comradef191/OpenShockMini/Mini/Gallery/r1.1_back.png

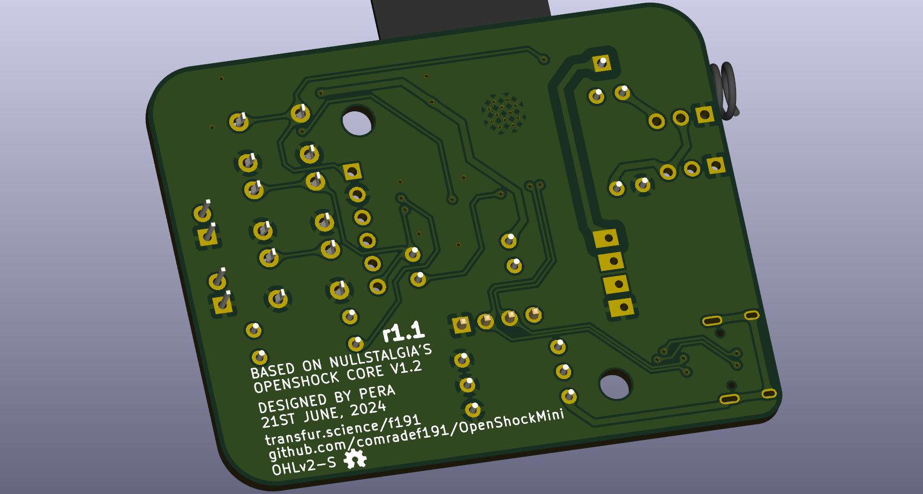
Mini/Gallery/r1.1_back.png
