comradef191/OpenShockMini/Mini/Gallery/r1.1_front-empty.png

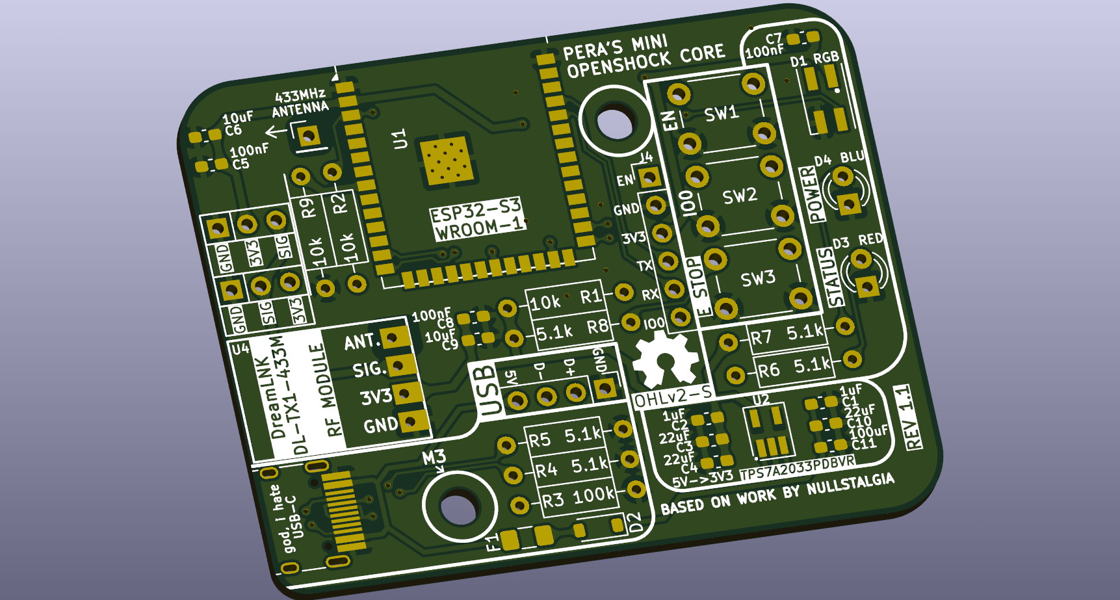
Mini/Gallery/r1.1_front-empty.png
