comradef191/OpenShockMini/Mini/Gallery/r1.1_front.png

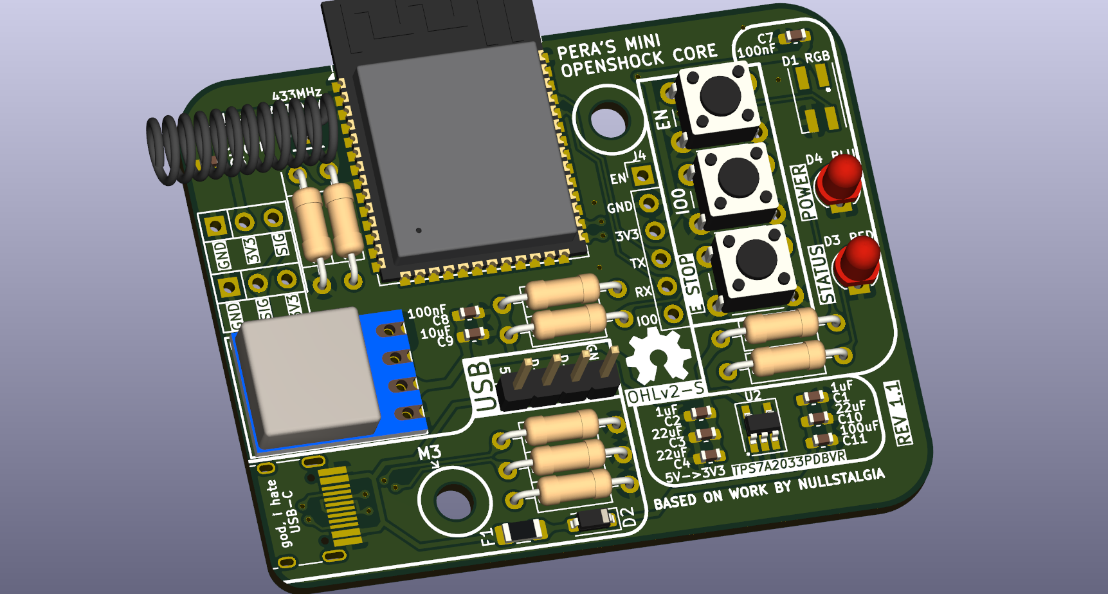
Mini/Gallery/r1.1_front.png
