comradef191/OpenShockMini/Mini/Schematic.pdf

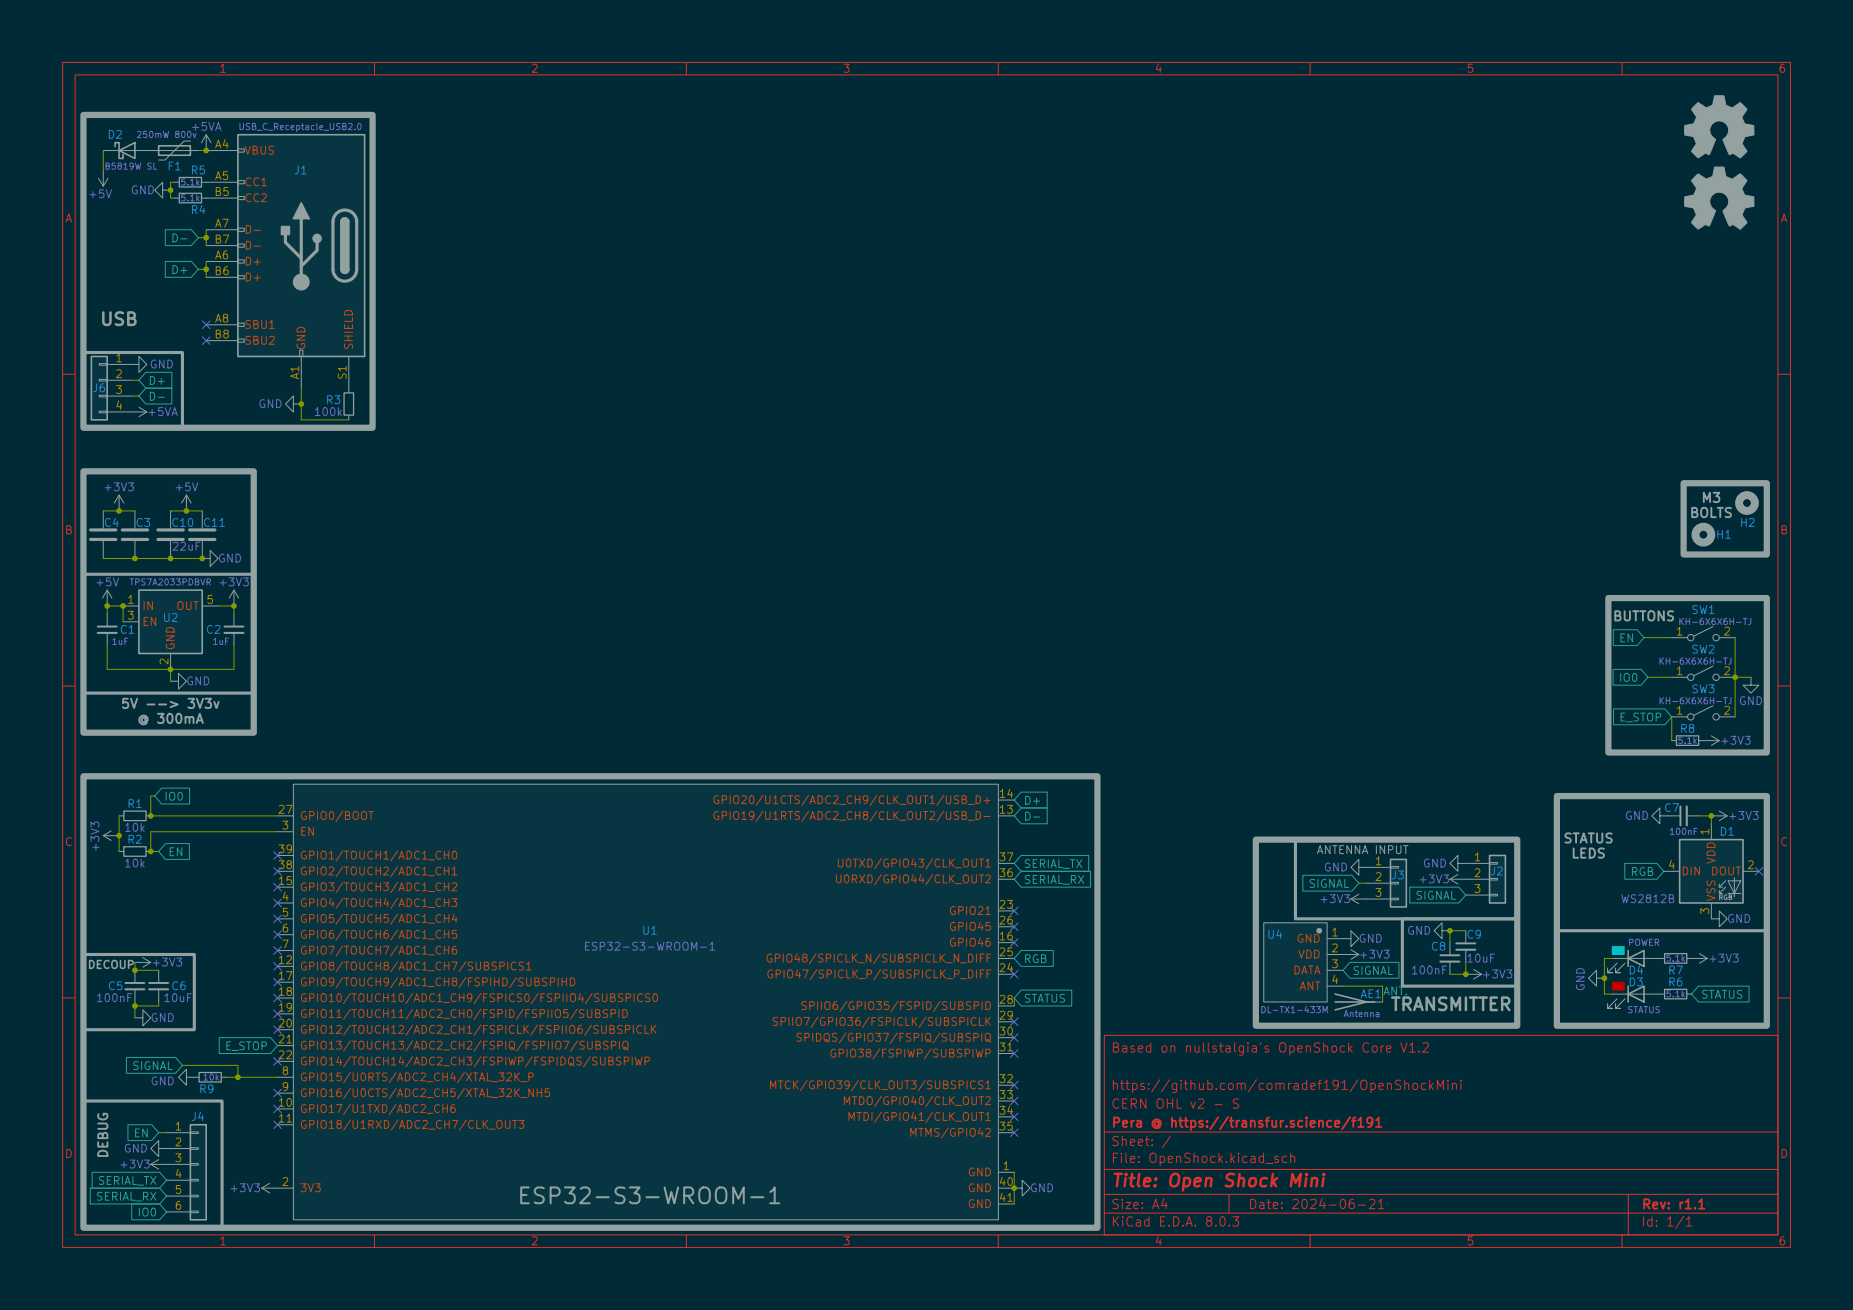
[picture p7: page 1]
