comradef191/OpenShockMini/Mini/OpenShock.kicad_pcb

## KiCad design Mini/OpenShock.kicad_pcb (2024-09-15)

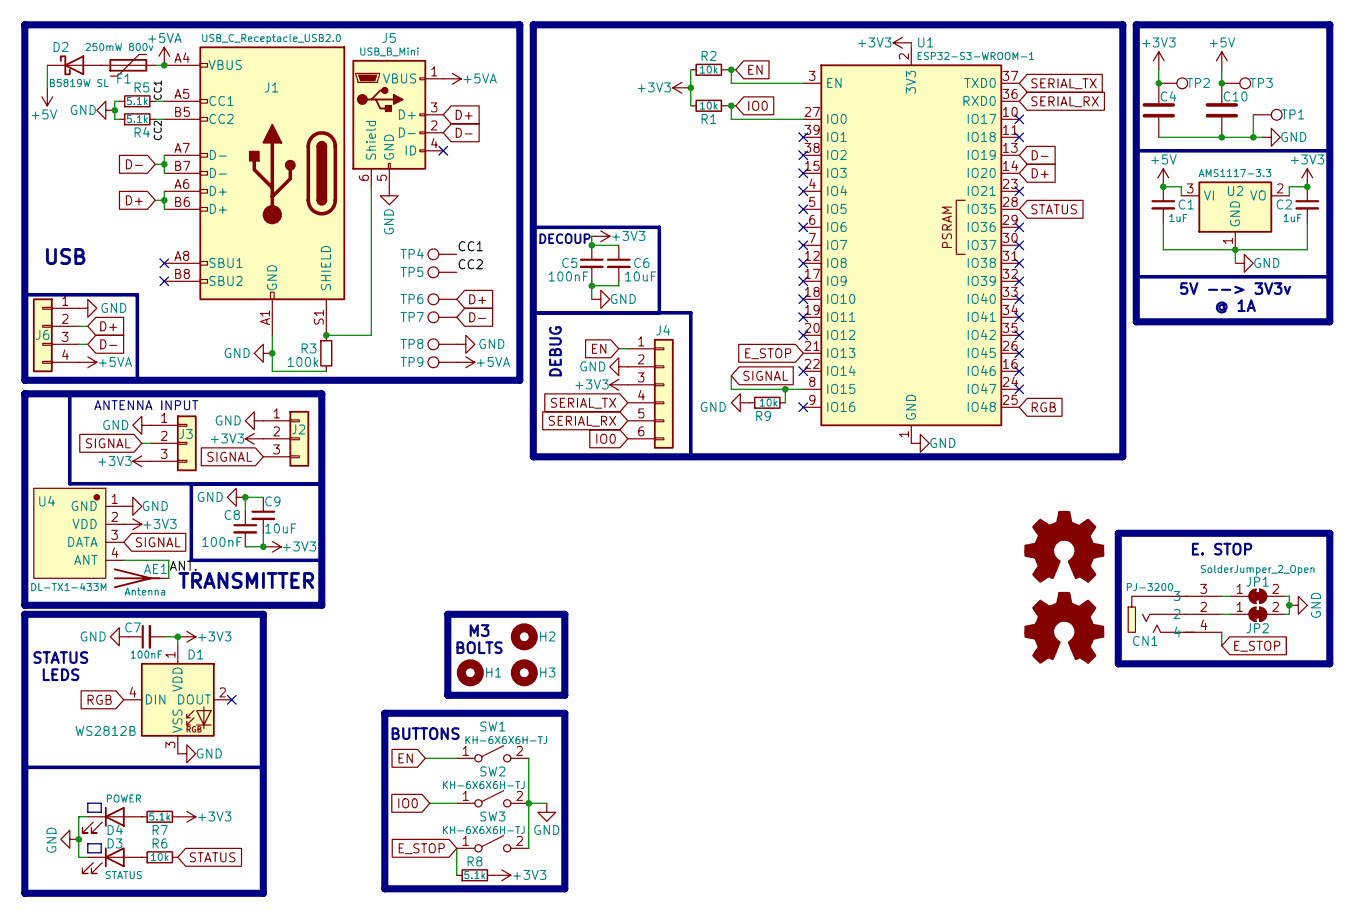
[picture p8: schematic OpenShock.kicad_sch, Open Shock Mini]

Parts:
AE1: Antenna; PinHeader_1x01_P2.54mm_Vertical
C1, C2: 1uF; C_0805_2012Metric_Pad1.18x1.45mm_HandSolder; LCSC C215803
C4, C10: 22uF; C_0805_2012Metric_Pad1.18x1.45mm_HandSolder; LCSC C98190
C5, C7, C8: 100nF; C_0805_2012Metric_Pad1.18x1.45mm_HandSolder; LCSC C476766
C6, C9: 10uF; C_0805_2012Metric_Pad1.18x1.45mm_HandSolder; LCSC C1713
CN1: PJ-3200; AUDIO-TH_PJ-3200; LCSC C2689690
D1: WS2812B; LED_WS2812B-Mini_3.5x3.5mm_P1.75mm; LCSC C527089
D2: B5819W SL; D_SOD-123; LCSC C8598
D3: STATUS; LED_D3.0mm; LCSC C440523
D4: POWER; LED_D3.0mm; LCSC C2895474
F1: 250mW 800v; Fuse_1206_3216Metric_Pad1.42x1.75mm_HandSolder; LCSC C17888
H1, H2, H3: MountingHole; MountingHole_3.2mm_M3_ISO7380
J1: USB_C_Receptacle_USB2.0; HRO-TYPE-C-31-M-12-HandSoldering_ABPads; LCSC C165948
J2, J3: Conn_01x03; PinHeader_1x03_P2.54mm_Vertical
J4: Conn_01x06; PinHeader_1x06_P2.54mm_Vertical
J5: USB_B_Mini; MICRO-USB-TH_UX-150-ARG4; LCSC C720612
J6: Conn_01x04; PinHeader_1x04_P2.54mm_Vertical
JP1, JP2: SolderJumper_2_Open; SolderJumper-2_P1.3mm_Bridged_RoundedPad1.0x1.5mm
R1, R2, R6, R9: 10k; THT-Resistor_Customised
R3: 100k; THT-Resistor_Customised
R4, R5, R7, R8: 5.1k; THT-Resistor_Customised
SW1, SW2, SW3: KH-6X6X6H-TJ; SW_PUSH_6mm; LCSC C2837516
TP1, TP2, TP3, TP4, TP5, TP6, TP7, TP8, TP9: TestPoint; TestPoint_Pad_D1.5mm
U1: ESP32-S3-WROOM-1; LCSC C2913202
U2: AMS1117-3.3; SOT-89-3_Handsoldering; LCSC C5120796
U4: DL-TX1-433M; WIELM-TH_DL-TX1-433M; LCSC C381160

Connections:
+3V3: C2.1, C4.1, C5.1, C6.1, C7.2, C8.2, C9.2, D1.1 (VDD), J2.2, J3.3, J4.3, R1.2, R2.1, R7.2, R8.2, TP2.1, U1.2 (3V3), U2.2 (VO), U4.2 (VDD)
+5V: C1.1, C10.1, D2.1 (K), TP3.1, U2.3 (VI)
+5VA: F1.2, J1.A4 (VBUS), J1.A9 (VBUS), J1.B4 (VBUS), J1.B9 (VBUS), J5.1 (VBUS), J6.4, TP9.1
/ANT.: AE1.1 (A), U4.4 (ANT)
/CC1: J1.A5 (CC1), R5.2, TP4.1
/CC2: J1.B5 (CC2), R4.2, TP5.1
D+: J1.A6 (D+), J1.B6 (D+), J5.3 (D+), J6.2, TP6.1, U1.14 (IO20)
D-: J1.A7 (D-), J1.B7 (D-), J5.2 (D-), J6.3, TP7.1, U1.13 (IO19)
EN: J4.1, R2.2, SW1.1 (A), U1.3 (EN)
E_STOP: CN1.4, R8.1, SW3.1 (A), U1.21 (IO13)
GND: C1.2, C2.2, C4.2, C5.2, C6.2, C7.1, C8.1, C9.1, C10.2, D1.3 (VSS), D3.1 (K), D4.1 (K), J1.A1 (GND), J1.A12 (GND), J1.B1 (GND), J1.B12 (GND), J2.1, J3.1, J4.2, J5.5 (GND), J6.1, JP1.2 (B), JP2.2 (B), R3.2, R4.1, R5.1, R9.1, SW1.2 (B), SW2.2 (B), SW3.2 (B), TP1.1, TP8.1, U1.1 (GND), U1.40 (GND), U1.41 (GND), U2.1 (GND), U4.1 (GND)
IO0: J4.6, R1.1, SW2.1 (A), U1.27 (IO0)
unnamed: D2.2 (A), F1.1
unnamed: D3.2 (A), R6.1
unnamed: D4.2 (A), R7.1
unnamed: J1.S1 (SHIELD), J5.6 (Shield), R3.1
unnamed: CN1.3, JP1.1 (A)
unnamed: CN1.2, JP2.1 (A)
RGB: D1.4 (DIN), U1.25 (IO48)
SERIAL_RX: J4.5, U1.36 (RXD0)
SERIAL_TX: J4.4, U1.37 (TXD0)
SIGNAL: J2.3, J3.2, R9.2, U1.8 (IO15), U4.3 (DATA)
STATUS: R6.2, U1.28 (IO35)

Notes on the sheet:
ANTENNA INPUT
TRANSMITTER
BUTTONS
M3 BOLTS
5V --> 3V3v @ 1A
DECOUP
STATUS LEDS
E. STOP
USB
DEBUG

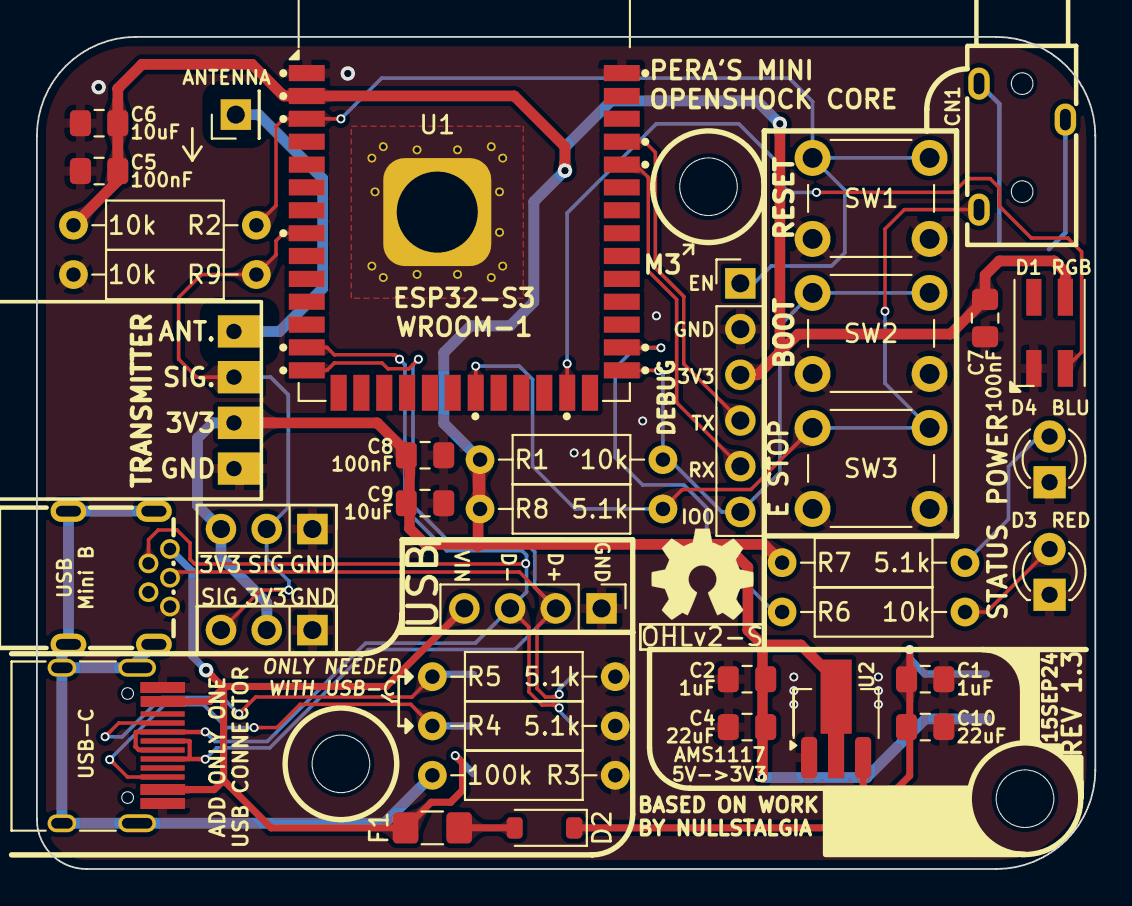
[picture p9: board OpenShock.kicad_pcb from above]

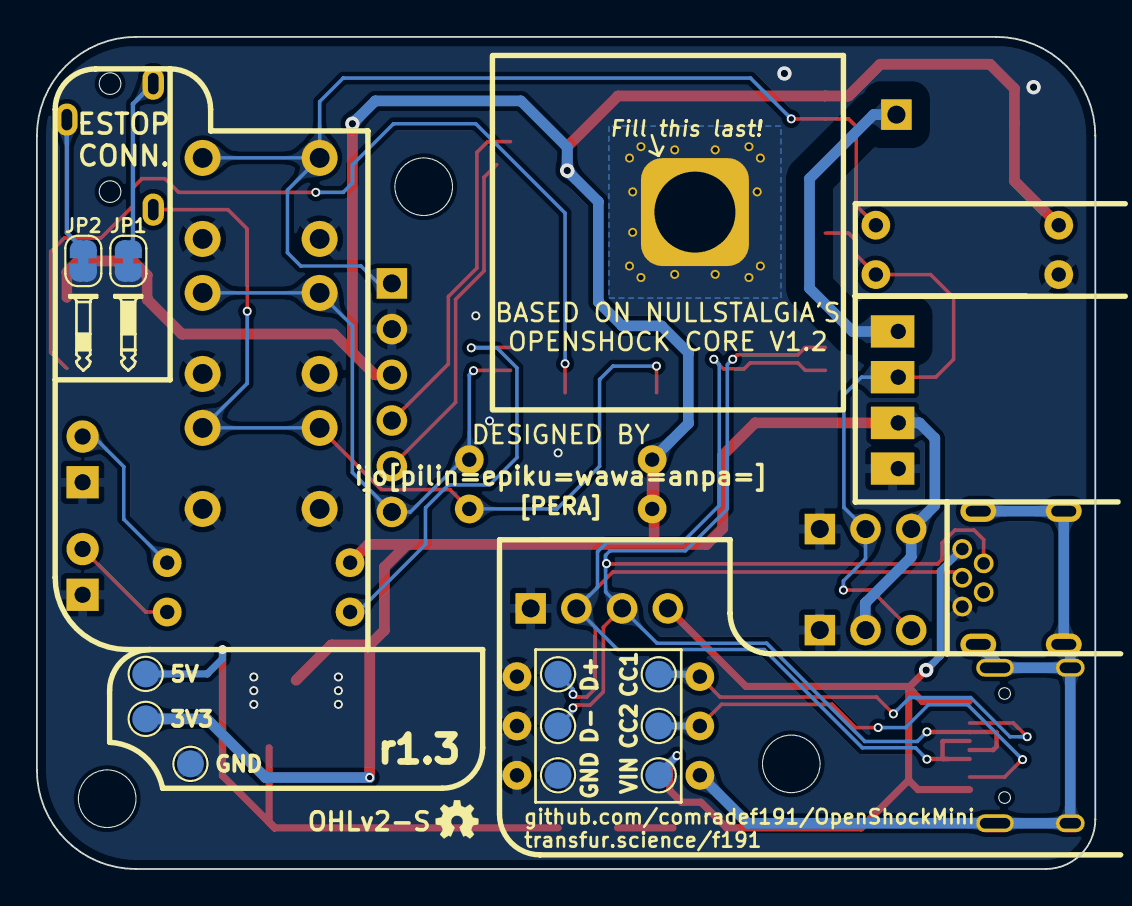
[picture p10: board OpenShock.kicad_pcb from below]

Board: 2 copper layers, 58.8 x 46.2 mm, 51 parts (11 on the bottom side), 23 nets.
