comradef191/OpenShockMini/(commit log)

2024-06-21 Add Mini files (WIP)
    [OpenShock.kicad_pcb, OpenShock.kicad_sch]
2024-06-21 Schematic Fixes & Add Title Blocks
    [OpenShock.kicad_pcb, OpenShock.kicad_sch]
2024-06-21 Update rear silkscreen
    [OpenShock.kicad_pcb]
2024-06-21 Finalisation of PCB files
    [OpenShock.kicad_pcb]
2024-06-21 Add schematic & 3D Model (TODO: Case / Mounting)
    [OpenShock.kicad_sch, OpenShockMini.step]
2024-06-21 also a gerbers zip. ill move this at Some Point:tm:
2024-06-21 Schematic Fixes + Add BoM
    [BillOfMaterials.csv, OpenShock.kicad_sch]
2024-06-21 R1.1; Upgrade from AMS1117 to Low-Noise TI chip; TPS7A2033PDBVR, 300mA output
    Added locally saved images of board, rather than Github cache.
    [BillOfMaterials.csv, OpenShock.kicad_pcb, OpenShock.kicad_sch]
2024-06-24 r1.2; Board reshuffled for ease of add-on design, plus ESP32 soldering
    [OpenShock.kicad_pcb, OpenShockMini.step]
2024-07-07 New revision; Board fixes
    [12vPCB.kicad_pcb, 12vPCB.kicad_sch, OpenShock.kicad_pcb, OpenShock.kicad_sch]
2024-09-15 New Revision.
    [OpenShock.kicad_pcb, OpenShock.kicad_sch, OpenShockMini.step]
