comradef191/OpenShockMini/(notices)

Notices in the files:
Mini/OpenShock.kicad_pcb:
CERN OHL v2 - S
